ajayre/djetecuconnector/Male/CAD/Connector CAD.png

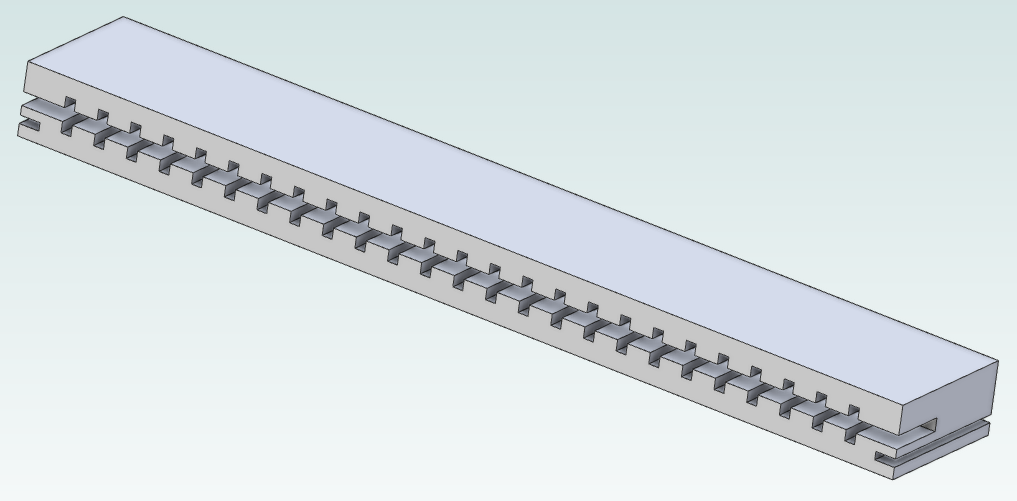
Male/CAD/Connector CAD.png
