ajayre/djetecuconnector/Male/CAD/ECU Connector Drawing.png

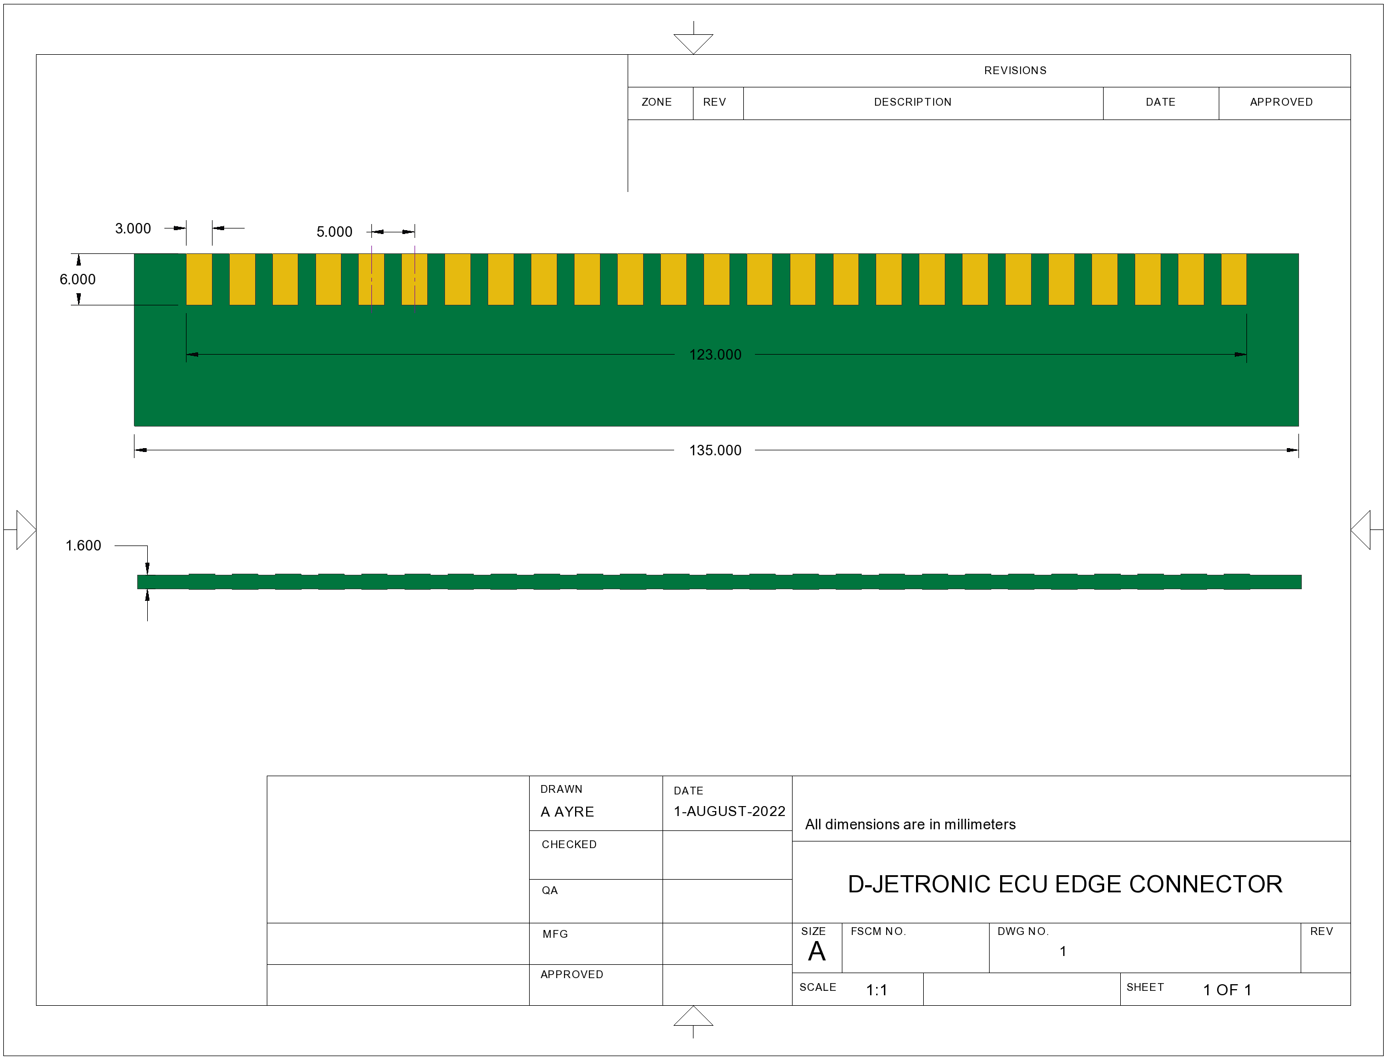
Male/CAD/ECU Connector Drawing.png
