ajayre/djetecuconnector/Female/Housing.stl

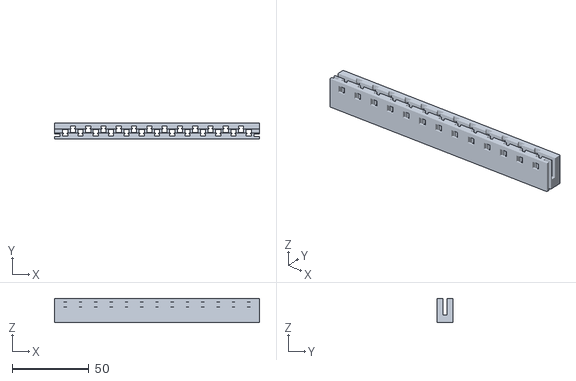
[picture p3: CAD file, 2024-01-10]
Female/Housing.stl
134.0 x 10.3 x 15.9
