ajayre/djetecuconnector/Original Female/Original Connector.stl

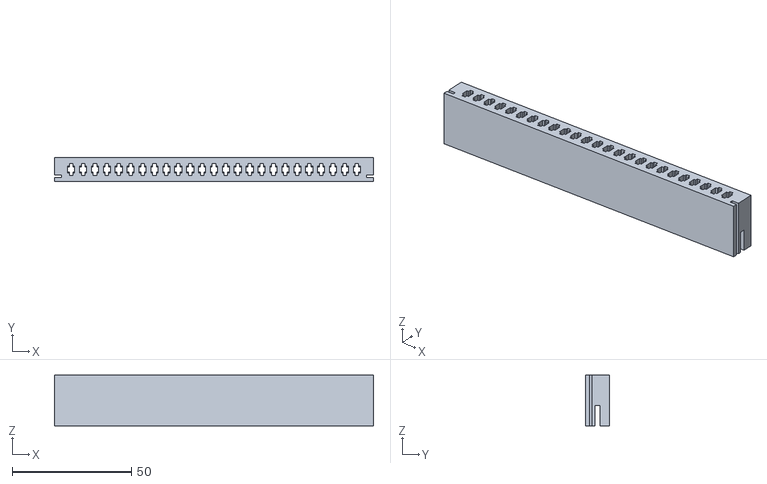
[picture p4: CAD file, 2023-10-07]
Original Female/Original Connector.stl
134.0 x 10.2 x 21.2
