ajayre/djetecuconnector/Female/Housing-WithHandle.stl

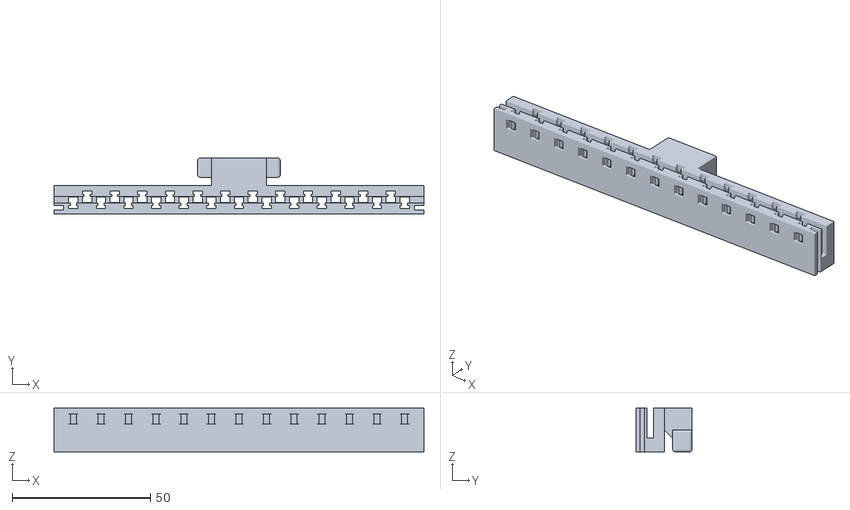
[picture p5: CAD file, 2024-01-10]
Female/Housing-WithHandle.stl
134.0 x 20.3 x 15.9
