ajayre/djetecuconnector/Female/c-0061668-31-as-3d.stp

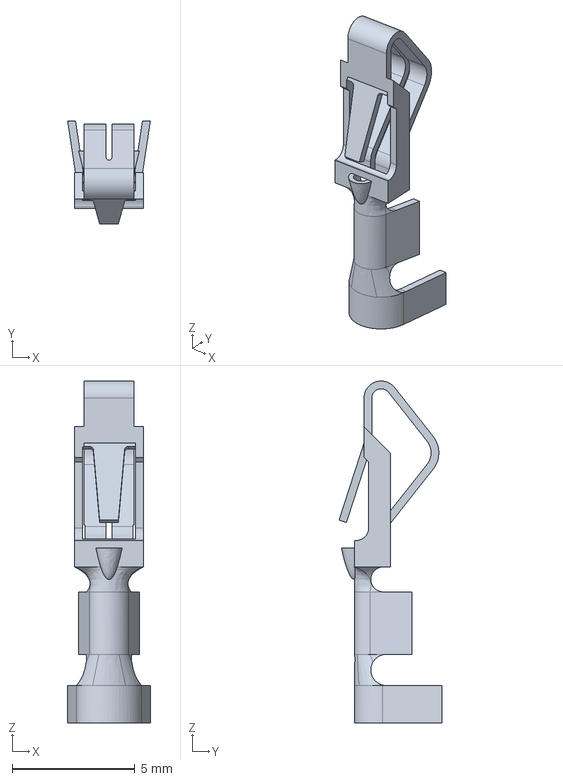
[picture p6: CAD file, 2023-10-07]
Female/c-0061668-31-as-3d.stp
3.37 x 4.19 x 13.9 mm
