ajayre/djetecuconnector/Original Female/Original Connector.pdf

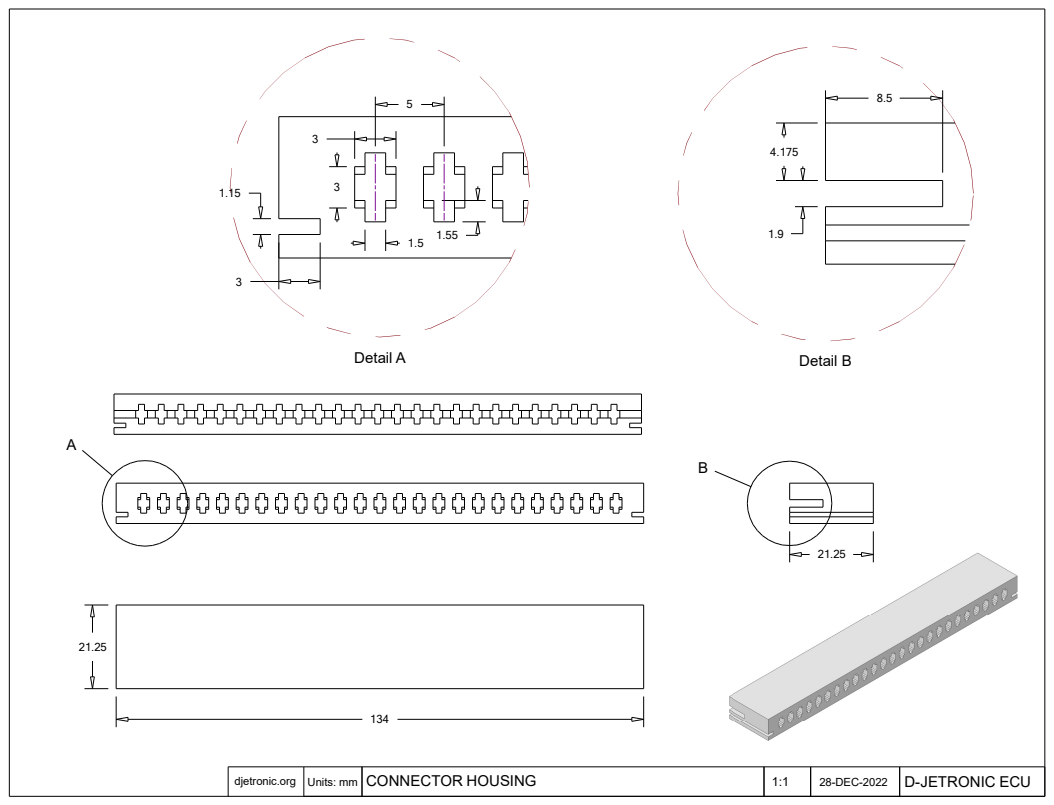
[picture p7: page 1]
Detail A; Detail B; djetronic.org; Units: mm; CONNECTOR HOUSING; 28-DEC-2022; D-JETRONIC ECU
