ajayre/djetecuconnector/Male/PCB/Male ECU Connector.kicad_pcb

## KiCad design Male/PCB/Male ECU Connector.kicad_pcb (2023-11-27)

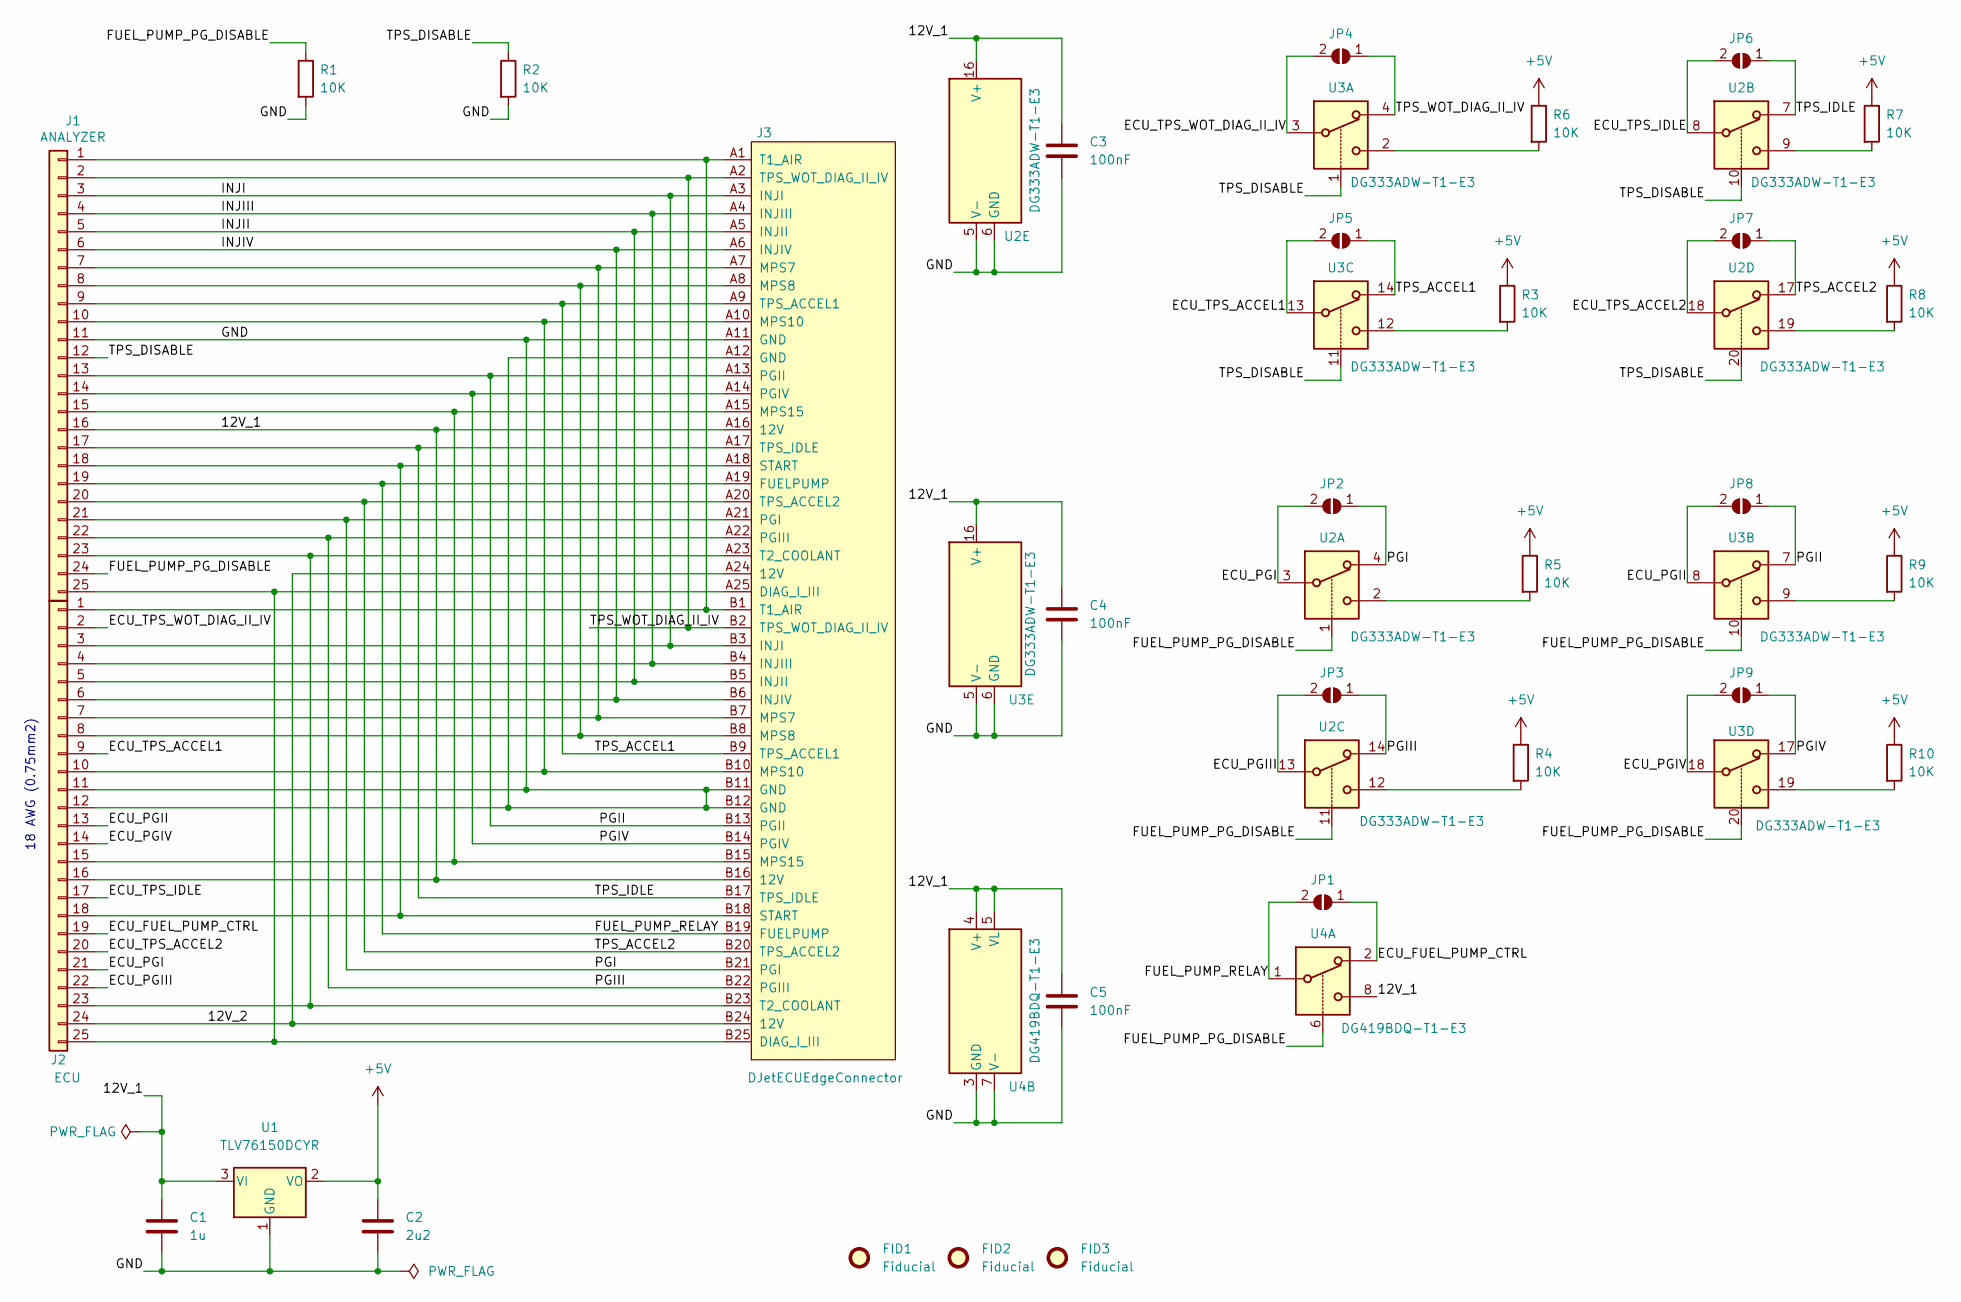
[picture p8: schematic Male ECU Connector.kicad_sch, Male ECU Connector for D-Jetronic]

Parts:
C1: 1u; C_0603_1608Metric
C2: 2u2; C_0603_1608Metric
C3, C4, C5: 100nF; C_0603_1608Metric
FID1, FID2, FID3: Fiducial; Fiducial_0.5mm_Mask1.5mm
J1: ANALYZER; DSUB-25_Female_Horizontal_P2.77x2.84mm_EdgePinOffset7.70mm_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
J2: ECU; Pins_1x25_P3.00mm_18AWG
J3: DJetECUEdgeConnector; D-Jetronic ECU Edge Connector
JP1, JP2, JP3, JP4, JP5, JP6, JP7, JP8, JP9: NO_ANALYZER; SolderJumper-2_P1.3mm_Open_TrianglePad1.0x1.5mm
R1, R2, R3, R4, R5, R6, R7, R8, R9, R10: 10K; R_0603_1608Metric
U1: TLV76150DCYR; SOT-223-3_TabPin2
U2, U3: DG333ADW-T1-E3; SOIC-20W_7.5x12.8mm_P1.27mm
U4: DG419BDQ-T1-E3; MSOP-8_3x3mm_P0.65mm

Connections:
+5V: C2.1, R3.1, R4.1, R5.1, R6.1, R7.1, R8.1, R9.1, R10.1, U1.2 (VO)
/12V_1: C1.1, C3.1, C4.1, C5.1, J1.16, J2.16, J3.A16 (12V), J3.B16 (12V), U1.3 (VI), U2.16 (V+), U3.16 (V+), U4.4 (V+), U4.5 (VL), U4.8
/12V_2: J2.24, J3.A24 (12V), J3.B24 (12V)
/ECU_FUEL_PUMP_CTRL: J2.19, JP1.1 (A), U4.2
/ECU_PGI: J2.21, JP2.2 (B), U2.3
/ECU_PGII: J2.13, JP8.2 (B), U3.8
/ECU_PGIII: J2.22, JP3.2 (B), U2.13
/ECU_PGIV: J2.14, JP9.2 (B), U3.18
/ECU_TPS_ACCEL1: J2.9, JP5.2 (B), U3.13
/ECU_TPS_ACCEL2: J2.20, JP7.2 (B), U2.18
/ECU_TPS_IDLE: J2.17, JP6.2 (B), U2.8
/ECU_TPS_WOT_DIAG_II_IV: J2.2, JP4.2 (B), U3.3
/FUEL_PUMP_PG_DISABLE: J1.24, R1.1, U2.1, U2.11, U3.10, U3.20, U4.6
/FUEL_PUMP_RELAY: J1.19, J3.A19 (FUELPUMP), J3.B19 (FUELPUMP), JP1.2 (B), U4.1
/GND: C1.2, C2.2, C3.2, C4.2, C5.2, J1.11, J2.11, J2.12, J3.A11 (GND), J3.A12 (GND), J3.B11 (GND), J3.B12 (GND), R1.2, R2.2, U1.1 (GND), U2.5 (V-), U2.6 (GND), U3.5 (V-), U3.6 (GND), U4.3 (GND), U4.7 (V-)
/INJI: J1.3, J2.3, J3.A3 (INJI), J3.B3 (INJI)
/INJII: J1.5, J2.5, J3.A5 (INJII), J3.B5 (INJII)
/INJIII: J1.4, J2.4, J3.A4 (INJIII), J3.B4 (INJIII)
/INJIV: J1.6, J2.6, J3.A6 (INJIV), J3.B6 (INJIV)
/PGI: J1.21, J3.A21 (PGI), J3.B21 (PGI), JP2.1 (A), U2.4
/PGII: J1.13, J3.A13 (PGII), J3.B13 (PGII), JP8.1 (A), U3.7
/PGIII: J1.22, J3.A22 (PGIII), J3.B22 (PGIII), JP3.1 (A), U2.14
/PGIV: J1.14, J3.A14 (PGIV), J3.B14 (PGIV), JP9.1 (A), U3.17
/TPS_ACCEL1: J1.9, J3.A9 (TPS_ACCEL1), J3.B9 (TPS_ACCEL1), JP5.1 (A), U3.14
/TPS_ACCEL2: J1.20, J3.A20 (TPS_ACCEL2), J3.B20 (TPS_ACCEL2), JP7.1 (A), U2.17
/TPS_DISABLE: J1.12, R2.1, U2.10, U2.20, U3.1, U3.11
/TPS_IDLE: J1.17, J3.A17 (TPS_IDLE), J3.B17 (TPS_IDLE), JP6.1 (A), U2.7
/TPS_WOT_DIAG_II_IV: J1.2, J3.A2 (TPS_WOT_DIAG_II_IV), J3.B2 (TPS_WOT_DIAG_II_IV), JP4.1 (A), U3.4
unnamed: J1.1, J2.1, J3.A1 (T1_AIR), J3.B1 (T1_AIR)
unnamed: J1.7, J2.7, J3.A7 (MPS7), J3.B7 (MPS7)
unnamed: J1.8, J2.8, J3.A8 (MPS8), J3.B8 (MPS8)
unnamed: J1.10, J2.10, J3.A10 (MPS10), J3.B10 (MPS10)
unnamed: J1.15, J2.15, J3.A15 (MPS15), J3.B15 (MPS15)
unnamed: J1.18, J2.18, J3.A18 (START), J3.B18 (START)
unnamed: J1.23, J2.23, J3.A23 (T2_COOLANT), J3.B23 (T2_COOLANT)
unnamed: J1.25, J2.25, J3.A25 (DIAG_I_III), J3.B25 (DIAG_I_III)
unnamed: R3.2, U3.12
unnamed: R4.2, U2.12
unnamed: R5.2, U2.2
unnamed: R6.2, U3.2
unnamed: R7.2, U2.9
unnamed: R8.2, U2.19
unnamed: R9.2, U3.9
unnamed: R10.2, U3.19

Notes on the sheet:
18 AWG (0.75mm2)

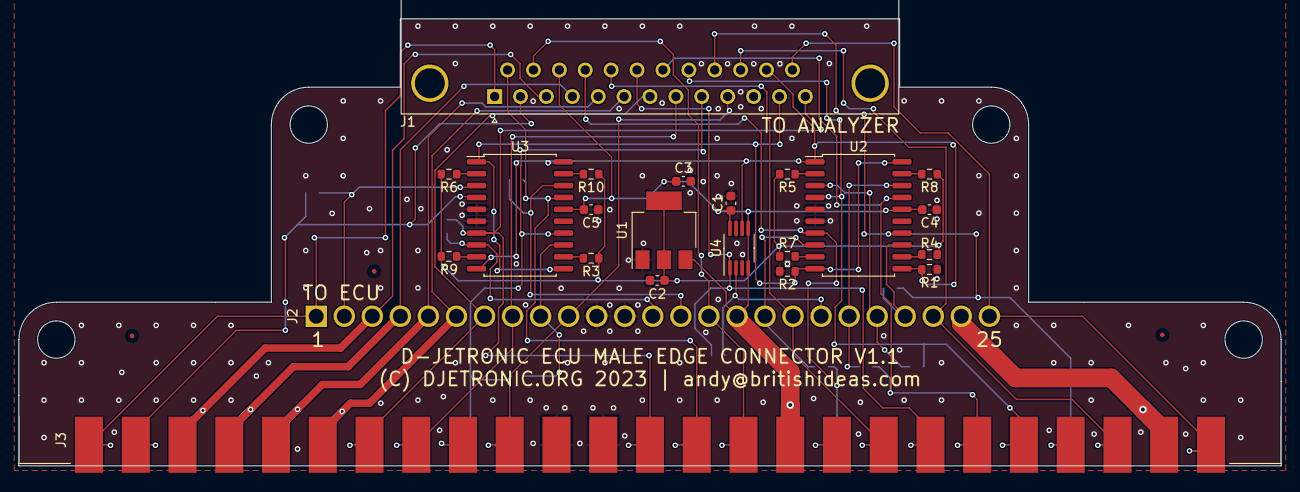
[picture p9: board Male ECU Connector.kicad_pcb from above]

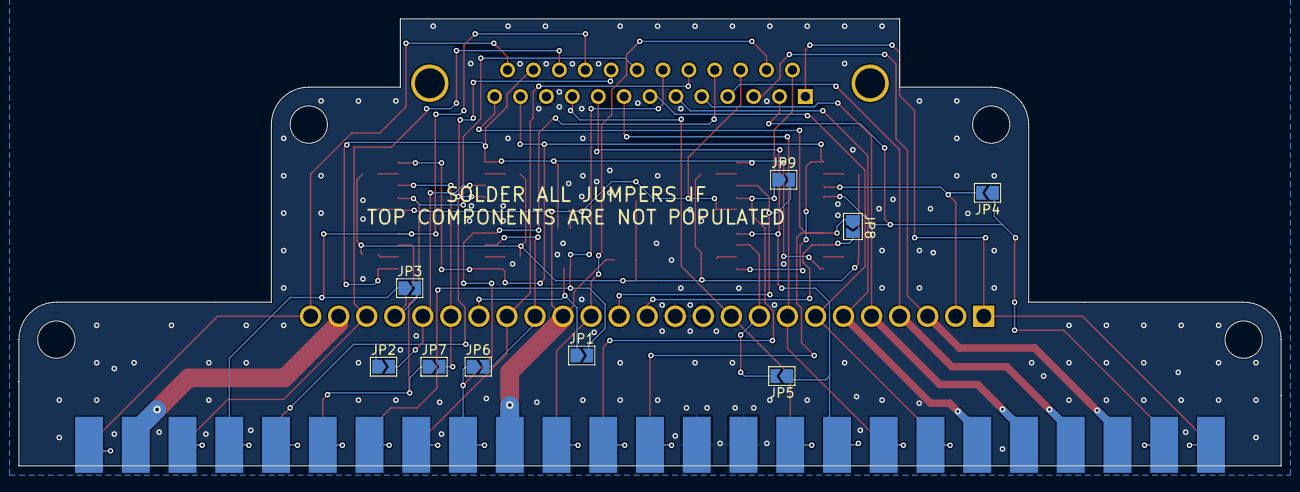
[picture p10: board Male ECU Connector.kicad_pcb from below]

Board: 2 copper layers, 135.0 x 47.8 mm, 34 parts (9 on the bottom side), 44 nets.
