ajayre/djetecuconnector/(commit log)

2022-05-01 Started work on connector idea.
    [c-1871059-1-b-3d.stp]
2022-05-03 Added small edge connector board for use in female ECU connector.
    [DJet Small Edge Connector Board.kicad_pcb, DJet Small Edge Connector Board.sch, DJet Small Edge Connector Board.step]
2022-05-03 Working on CAD model.
2022-05-03 Added CAD model of PCB.
2022-05-03 Updated CAD model and removed unused files.
    [c-1871059-1-b-3d.stp]
2022-05-04 Working on case.
2022-05-15 Work in progress.
    [DJet Small Edge Connector Board.kicad_pcb, DJet Small Edge Connector Board.step]
2022-12-28 Working on updated design.
    [DJet Small Edge Connector Board.sch]
2023-10-07 3D printed connector.
    [DJet Small Edge Connector Board.kicad_pcb, DJet Small Edge Connector Board.sch, DJet Small Edge Connector Board.step, c-0061668-31-as-3d.stp]
2023-10-07 Renamed folder
    [Housing.stl, c-0061668-31-as-3d.stp]
2023-10-07 Added male connector. Added original female connector.
    [Original Connector.stl]
2023-10-20 Added male connector PCB
    [Male ECU Connector.kicad_pcb, Male ECU Connector.sch]
2023-10-20 Moved CAD files.
2023-10-21 Converted project to KiCAD 6.
    [Male ECU Connector.kicad_pcb, Male ECU Connector.kicad_sch, Male ECU Connector.sch]
2023-10-21 Added relay to disable fuel pump.
    [Male ECU Connector.kicad_pcb, Male ECU Connector.kicad_sch]
2023-10-21 Added larger holes for 18AWG (0.75mm2) engine harness wires. Rounded back corners of PCB to make it easier to design case. Added solder jumper to make relay optional.
    [Male ECU Connector.kicad_pcb, Male ECU Connector.kicad_sch]
2023-11-05 Laid out PCB fpr male connector.
    [Housing.stl, Male ECU Connector.kicad_pcb, Male ECU Connector.kicad_sch]
2023-11-11 Completed PCB design for male connector.
    [Male ECU Connector-B_Cu.gbr, Male ECU Connector-B_Mask.gbr, Male ECU Connector-B_Paste.gbr, Male ECU Connector-B_Silkscreen.gbr, Male ECU Connector-Edge_Cuts.gbr, Male ECU Connector-F_Cu.gbr, Male ECU Connector-F_Mask.gbr, Male ECU Connector-F_Paste.gbr]
2023-11-20 Changed analyzer connector to DB25.
    [Male ECU Connector-B_Cu.gbr, Male ECU Connector-B_Mask.gbr, Male ECU Connector-B_Paste.gbr, Male ECU Connector-B_Silkscreen.gbr, Male ECU Connector-Edge_Cuts.gbr, Male ECU Connector-F_Cu.gbr, Male ECU Connector-F_Mask.gbr, Male ECU Connector-F_Paste.gbr]
2023-11-20 Added CAD model.
2023-11-20 Added gold fingers to CAD model.
2023-11-27 Added additional mounting holes and reduced PCB size. Added first version of housing.
    [Male ECU Connector-B_Cu.gbr, Male ECU Connector-B_Mask.gbr, Male ECU Connector-B_Paste.gbr, Male ECU Connector-B_Silkscreen.gbr, Male ECU Connector-Edge_Cuts.gbr, Male ECU Connector-F_Cu.gbr, Male ECU Connector-F_Mask.gbr, Male ECU Connector-F_Paste.gbr]
2024-01-10 Final female housing with and without a handle.
    [Housing-WithHandle.stl, Housing.stl]
